yarmolinskiyam/ball_balance/solidworks/sketch_asm.SLDASM

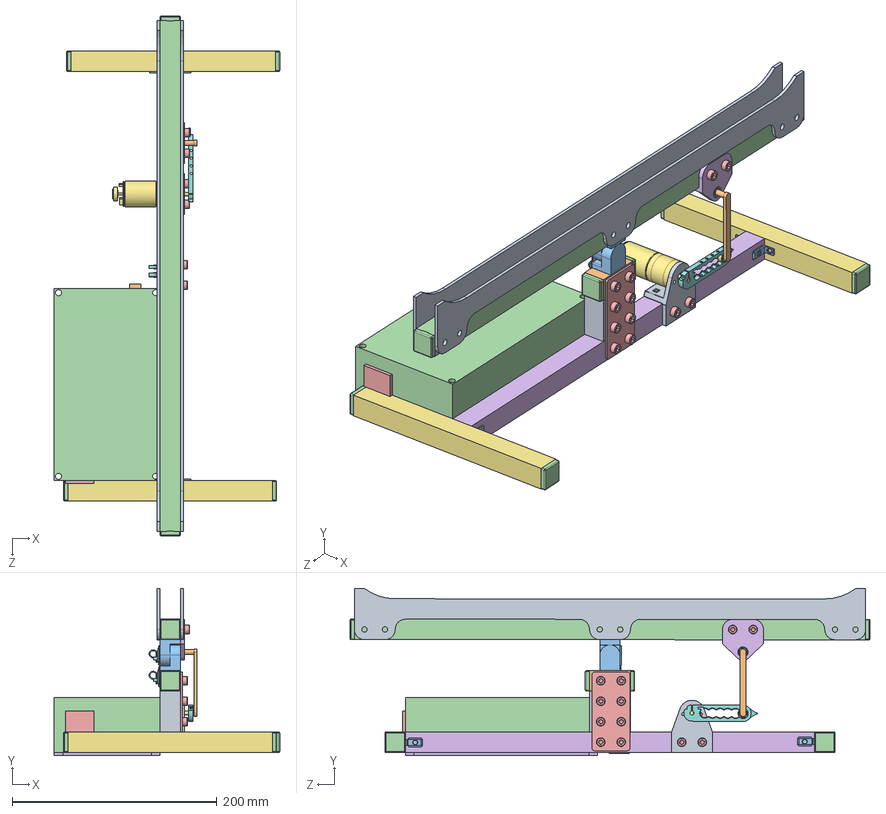
[picture p1: CAD file, 2023-07-05]
solidworks/sketch_asm.SLDASM
220.5 x 163.3 x 508.4 mm
алюм40мм^sketch_asm x 2
алюм40мм2^sketch_asm
Шарнирный соединитель 20х20, паз 6, H11^sketch_asm x 2
алюм500мм^sketch_asm
M50-Soedinitel-40kh80
arm_rocker
radial ball bearing_68_din x 2
lever
25d_motor_mount
rocker
Внутренний угловой соединитель 6-А, паз 6, H19 x 4
Заглушка торцевая 20 х 20, H17 x 8
socket head cap screw_din x 12
alum400
alum200 x 2
RS-25-5, Блок питания, 5В,5А,25Вт
Блок питания 3а 36вт 12в ip20
Simplified UNO
L298N Driver DC Motor, Stepper Motor
G1025BF, Корпус для РЭА 225х113х63мм, пластик, черный с крепежным фланцем
Разъем220сВыкл
фанераОснование
Cylindrical Brushed DC Motor
wire tie clip x 3
фанераРельс x 2
