yarmolinskiyam/ball_balance/solidworks/dxf/креплениеСонара^Сборка2_sketch_asm.DXF

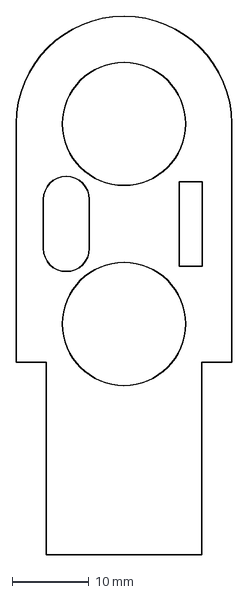
[picture p2: CAD file, 2023-07-08]
solidworks/dxf/креплениеСонара^Сборка2_sketch_asm.DXF
28.0 x 70.0 mm
