yarmolinskiyam/ball_balance/solidworks/dxf/фанераРельс_final1.DXF

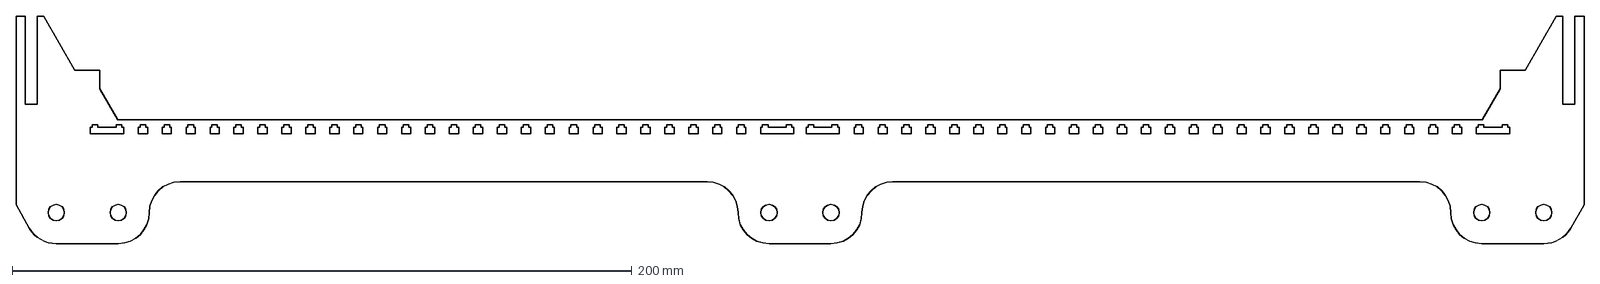
[picture p3: CAD file, 2023-07-08]
solidworks/dxf/фанераРельс_final1.DXF
506.0 x 73.3 mm
