yarmolinskiyam/ball_balance/solidworks/misc/rail_ho_g231.SLDPRT

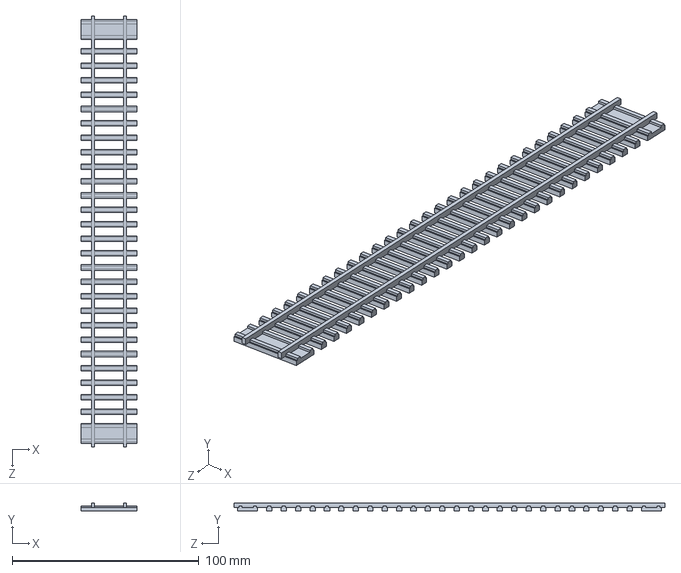
[picture p4: CAD file, 2023-07-08]
solidworks/misc/rail_ho_g231.SLDPRT
30.0 x 4.50 x 231.0 mm
