yarmolinskiyam/ball_balance/solidworks/фанераОснование.sldprt

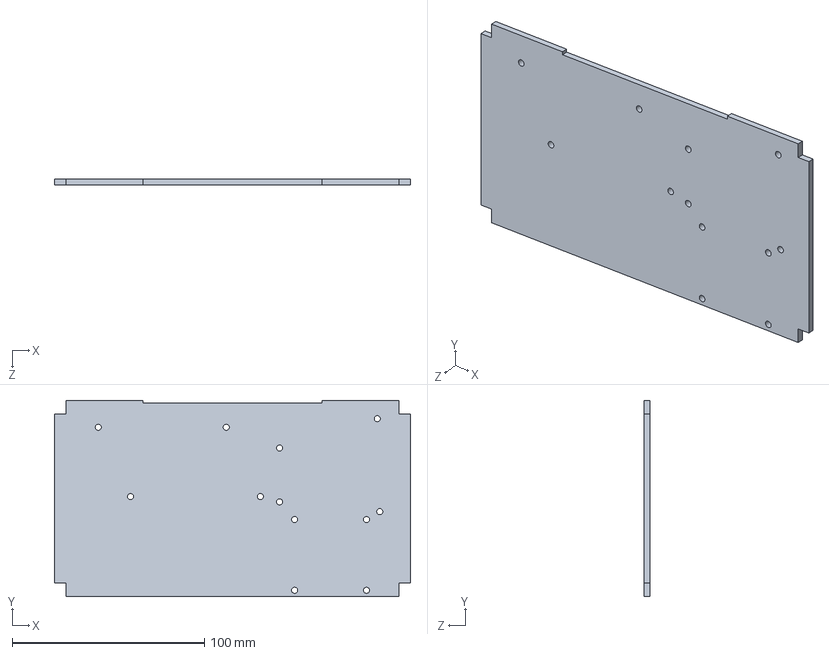
[picture p5: CAD file, 2023-07-08]
solidworks/фанераОснование.sldprt
185.0 x 102.0 x 3.00 mm
