yarmolinskiyam/ball_balance/solidworks/dxf/фанераОснование2.DXF

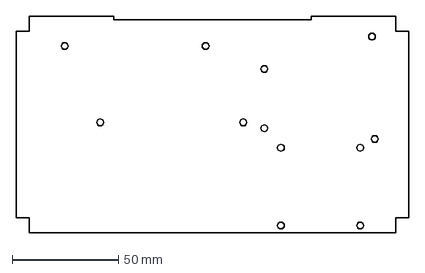
[picture p6: CAD file, 2023-07-08]
solidworks/dxf/фанераОснование2.DXF
185.0 x 102.0 mm
