yarmolinskiyam/ball_balance/solidworks/misc/G1025BF, Корпус для РЭА 225х113х63мм, пластик, черный с крепежным фланцем.SLDPRT

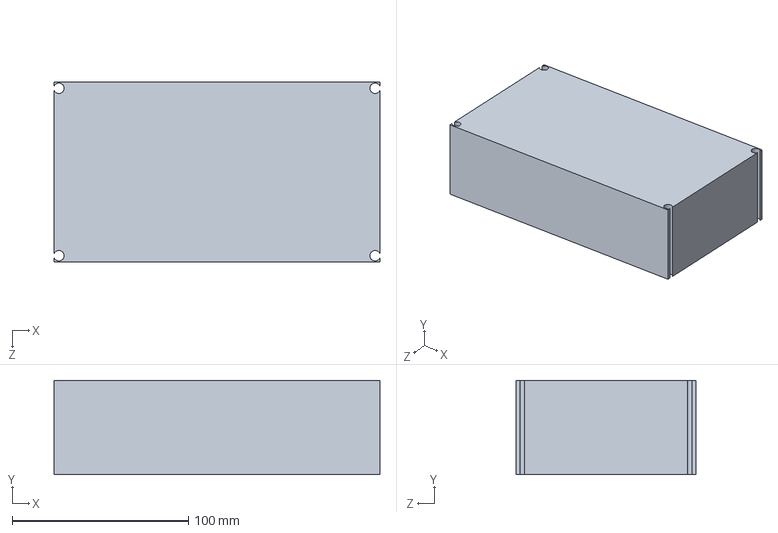
[picture p7: CAD file, 2023-07-08]
solidworks/misc/G1025BF, Корпус для РЭА 225х113х63мм, пластик, черный с крепежным фланцем.SLDPRT
185.0 x 53.5 x 102.0 mm
