yarmolinskiyam/ball_balance/solidworks/фанераРельс.SLDPRT

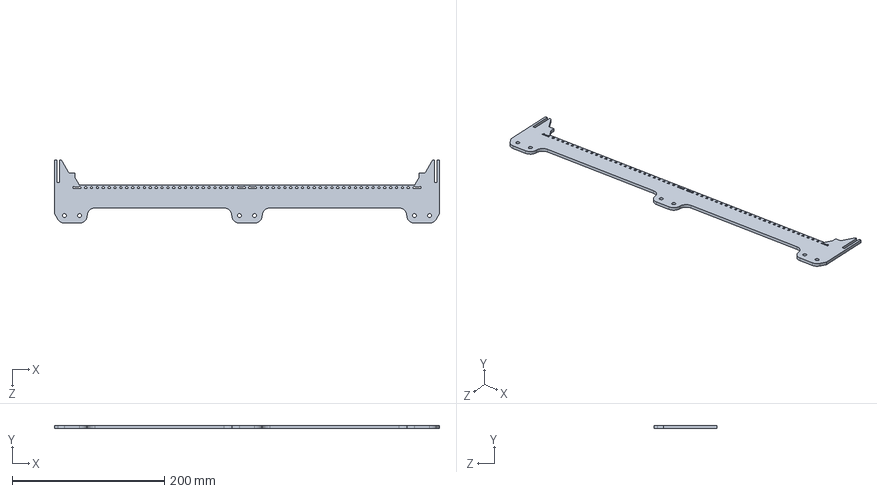
[picture p8: CAD file, 2023-07-08]
solidworks/фанераРельс.SLDPRT
506.0 x 4.00 x 83.3 mm
