yarmolinskiyam/ball_balance/solidworks/dxf/фанераРельс_final2.DXF

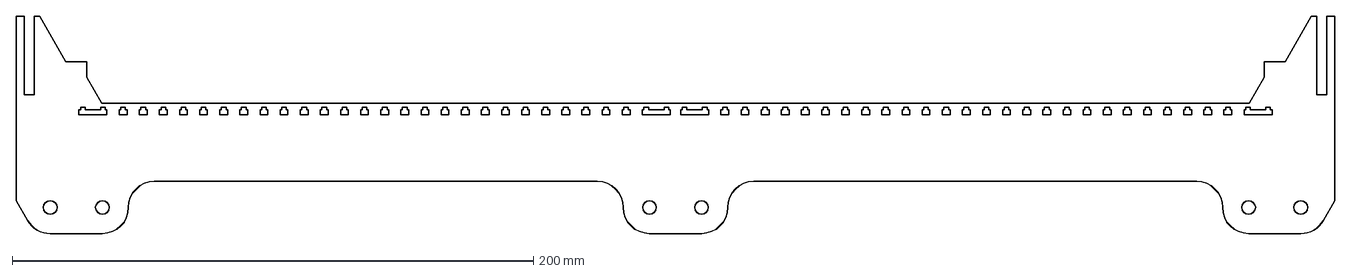
[picture p9: CAD file, 2023-07-08]
solidworks/dxf/фанераРельс_final2.DXF
506.0 x 83.3 mm
