yarmolinskiyam/ball_balance/solidworks/misc/hc-sr04.SLDPRT

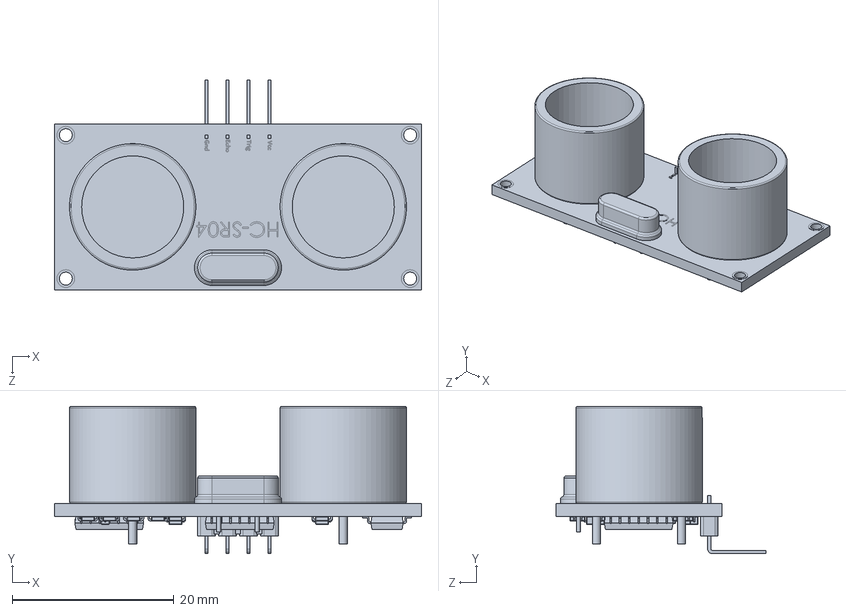
[picture p10: CAD file, 2023-07-08]
solidworks/misc/hc-sr04.SLDPRT
45.3 x 18.2 x 25.9 mm
