yarmolinskiyam/ball_balance/solidworks/креплениеМотора25d.SLDPRT

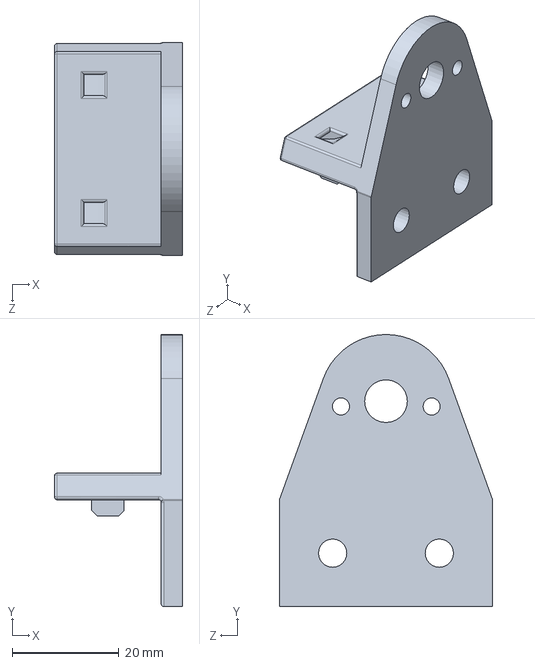
[picture p11: CAD file, 2023-07-08]
solidworks/креплениеМотора25d.SLDPRT
24.0 x 51.0 x 40.0 mm
