yarmolinskiyam/ball_balance/solidworks/dxf/фанераРельс_piko.DXF

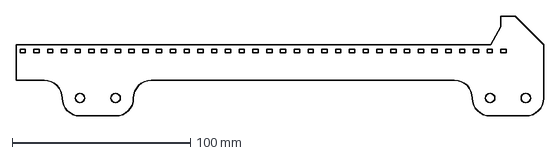
[picture p12: CAD file, 2023-07-08]
solidworks/dxf/фанераРельс_piko.DXF
295.7 x 56.0 mm
