yarmolinskiyam/ball_balance/solidworks/misc/Simplified UNO.SLDPRT

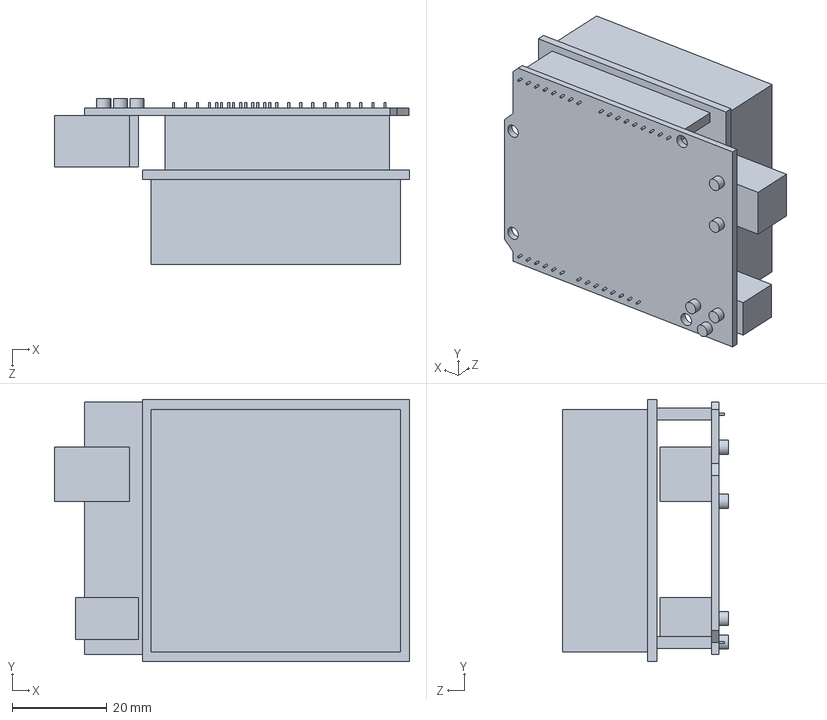
[picture p13: CAD file, 2023-07-05]
solidworks/misc/Simplified UNO.SLDPRT
75.0 x 55.5 x 35.1 mm
