yarmolinskiyam/ball_balance/solidworks/креплениеТяги.SLDPRT

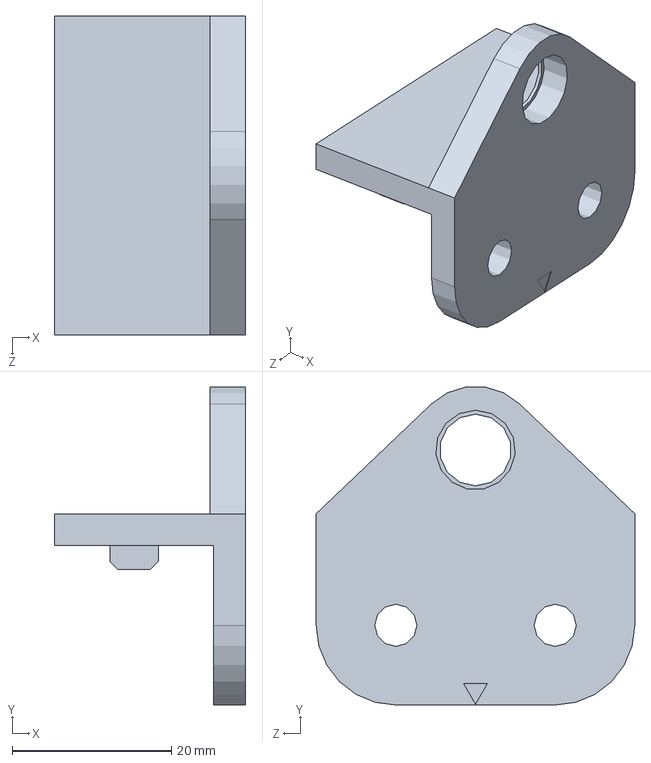
[picture p14: CAD file, 2023-07-08]
solidworks/креплениеТяги.SLDPRT
24.0 x 39.9 x 40.0 mm
