yarmolinskiyam/ball_balance/solidworks/dxf/креплениеСонара2.DXF

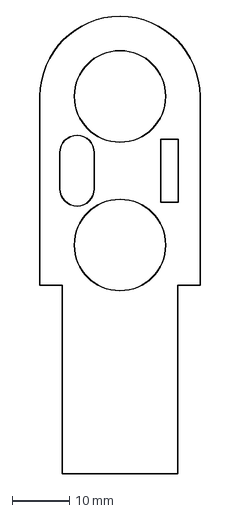
[picture p15: CAD file, 2023-07-08]
solidworks/dxf/креплениеСонара2.DXF
28.0 x 80.0 mm
