yarmolinskiyam/ball_balance/solidworks/misc/Разъем220сВыкл.SLDPRT

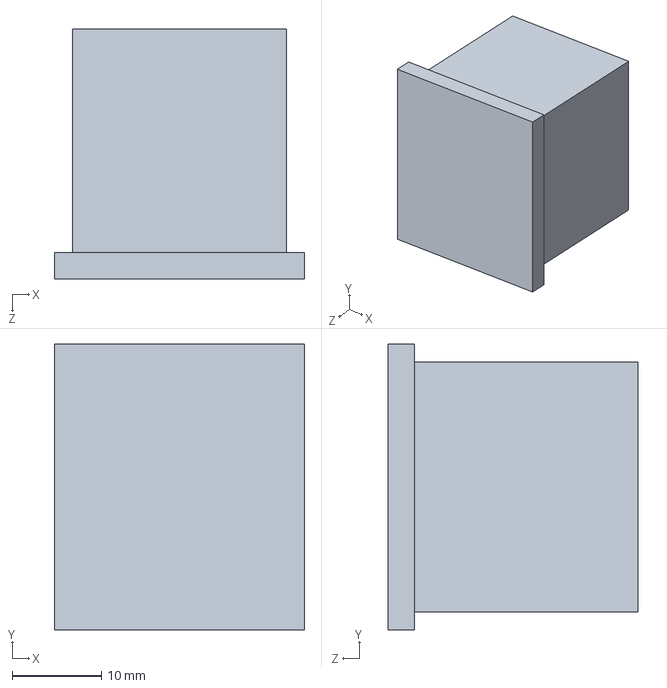
[picture p16: CAD file, 2023-07-03]
solidworks/misc/Разъем220сВыкл.SLDPRT
28.0 x 32.0 x 28.0 mm
