yarmolinskiyam/ball_balance/solidworks/dxf/фанераРельс_sonar.DXF

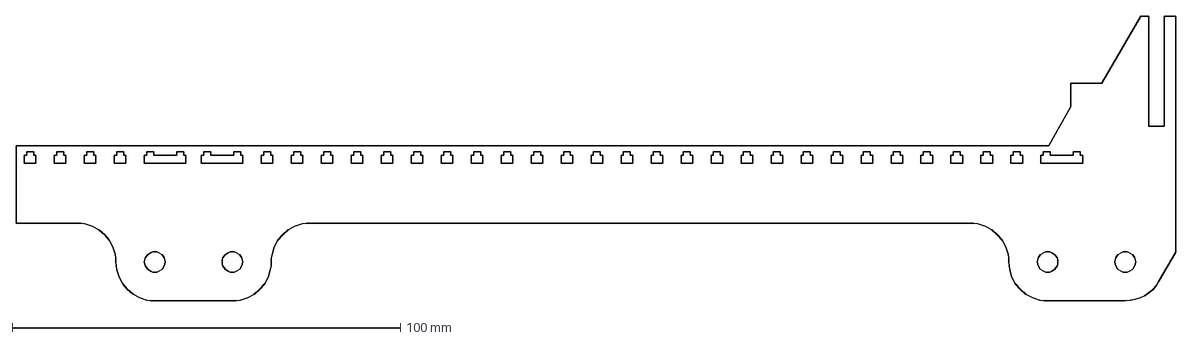
[picture p17: CAD file, 2023-07-08]
solidworks/dxf/фанераРельс_sonar.DXF
298.7 x 73.3 mm
