yarmolinskiyam/ball_balance/solidworks/lever.SLDPRT

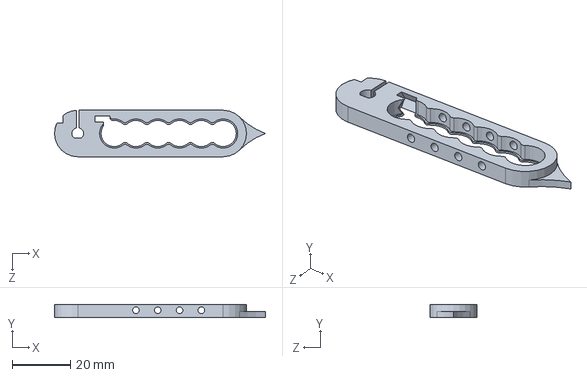
[picture p18: CAD file, 2023-07-05]
solidworks/lever.SLDPRT
72.5 x 4.50 x 16.0 mm
