yarmolinskiyam/ball_balance/solidworks/misc/Блок питания 3а 36вт 12в ip20.SLDPRT

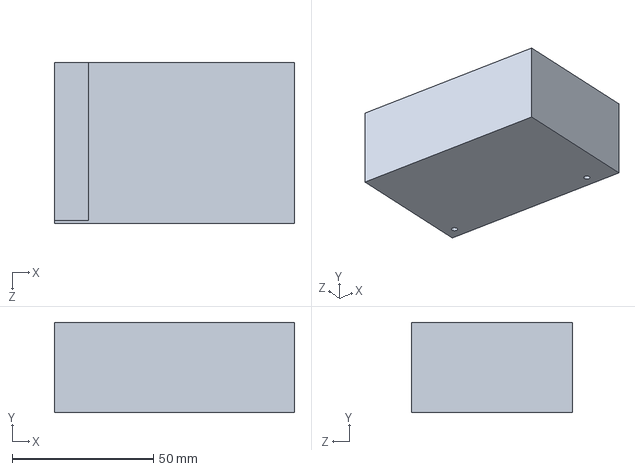
[picture p19: CAD file, 2023-07-03]
solidworks/misc/Блок питания 3а 36вт 12в ip20.SLDPRT
85.0 x 32.0 x 57.0 mm
