yarmolinskiyam/ball_balance/solidworks/dxf/фанераРельс_piko2.DXF

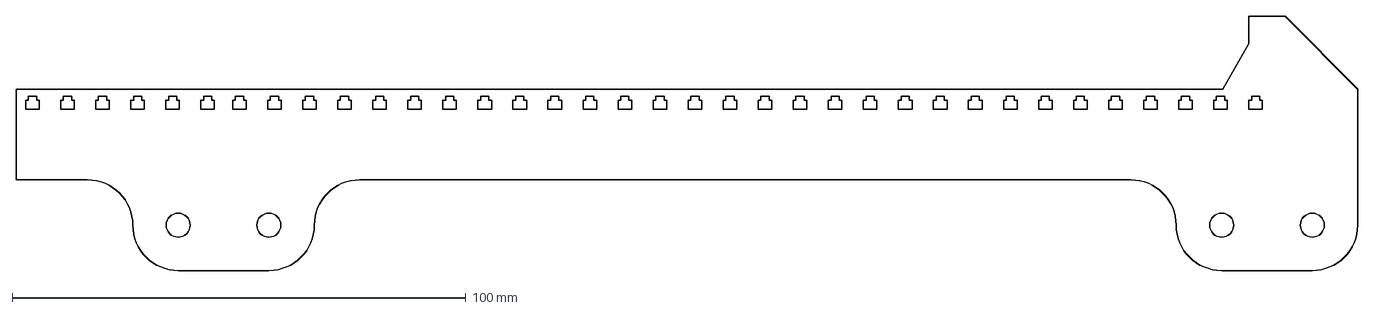
[picture p20: CAD file, 2023-07-08]
solidworks/dxf/фанераРельс_piko2.DXF
295.7 x 56.0 mm
