yarmolinskiyam/ball_balance/solidworks/misc/RS-25-5, Блок питания, 5В,5А,25Вт.SLDPRT

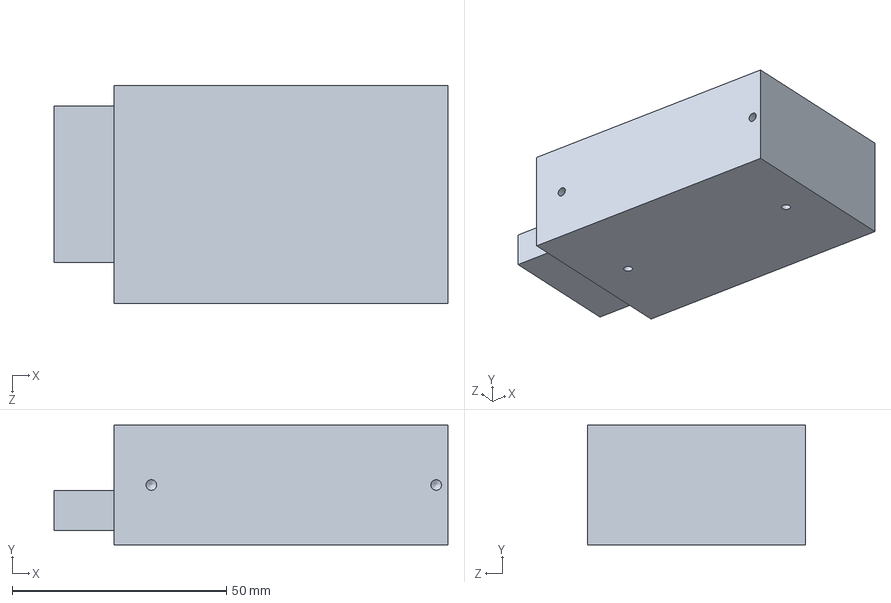
[picture p21: CAD file, 2023-06-30]
solidworks/misc/RS-25-5, Блок питания, 5В,5А,25Вт.SLDPRT
92.0 x 28.0 x 51.0 mm
