yarmolinskiyam/ball_balance/solidworks/rocker.SLDPRT

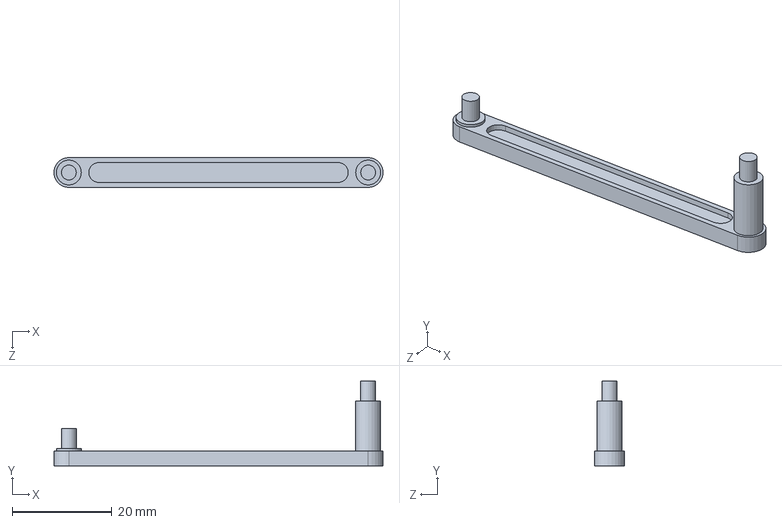
[picture p22: CAD file, 2023-06-30]
solidworks/rocker.SLDPRT
66.0 x 17.0 x 6.00 mm
