yarmolinskiyam/ball_balance/solidworks/arm_rocker_led.SLDPRT

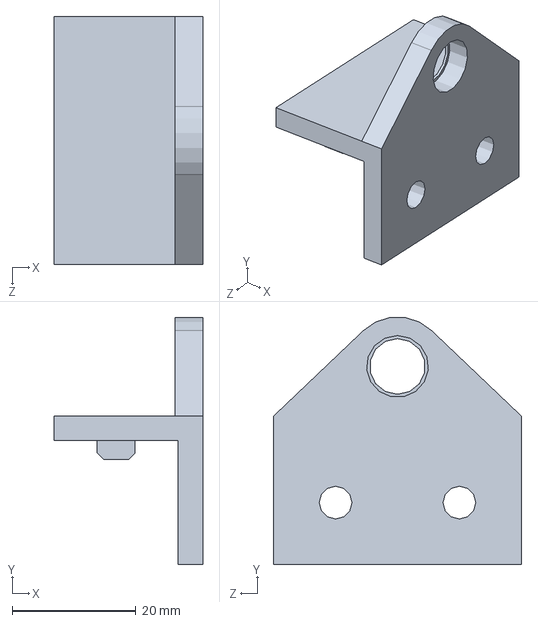
[picture p23: CAD file, 2023-06-28]
solidworks/arm_rocker_led.SLDPRT
24.0 x 39.9 x 40.0 mm
