yarmolinskiyam/ball_balance/solidworks/misc/Cylindrical Brushed DC Motor.SLDPRT

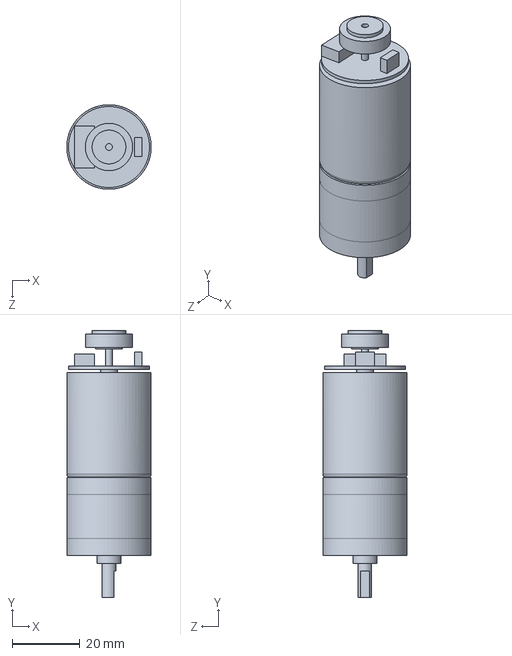
[picture p24: CAD file, 2023-06-30]
solidworks/misc/Cylindrical Brushed DC Motor.SLDPRT
25.0 x 79.0 x 25.0 mm
