yarmolinskiyam/ball_balance/solidworks/alum400.sldprt

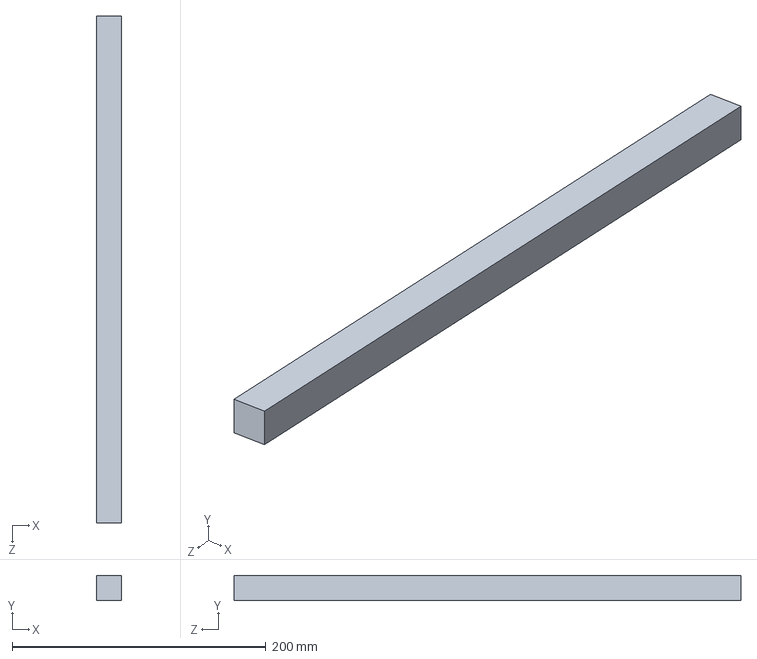
[picture p25: CAD file, 2023-06-28]
solidworks/alum400.sldprt
20.0 x 20.0 x 400.0 mm
