yarmolinskiyam/ball_balance/solidworks/misc/L298N Driver DC Motor, Stepper Motor.SLDPRT

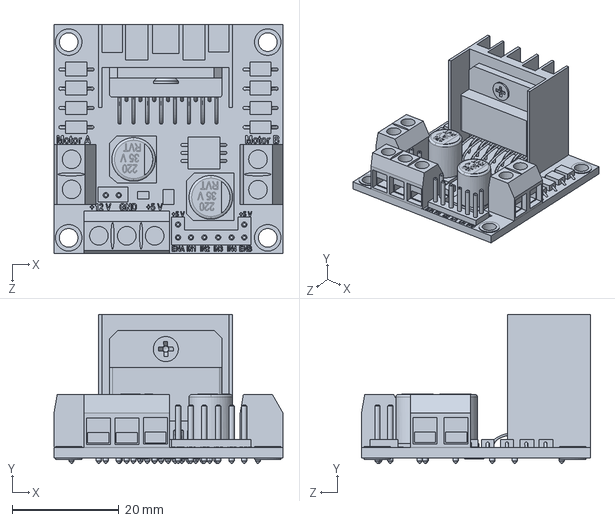
[picture p26: CAD file, 2023-06-30]
solidworks/misc/L298N Driver DC Motor, Stepper Motor.SLDPRT
43.0 x 28.0 x 43.0 mm
