yarmolinskiyam/ball_balance/solidworks/alum200.sldprt

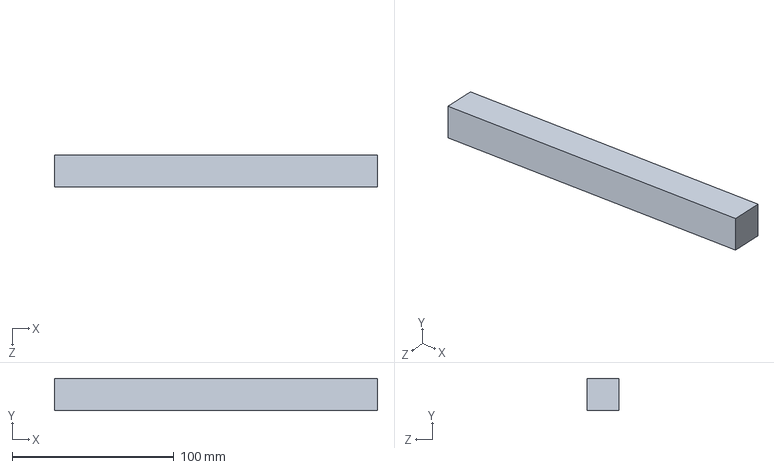
[picture p27: CAD file, 2023-06-28]
solidworks/alum200.sldprt
200.0 x 20.0 x 20.0 mm
