yarmolinskiyam/ball_balance/solidworks/misc/Внутренний угловой соединитель 6-А, паз 6, H19.SLDPRT

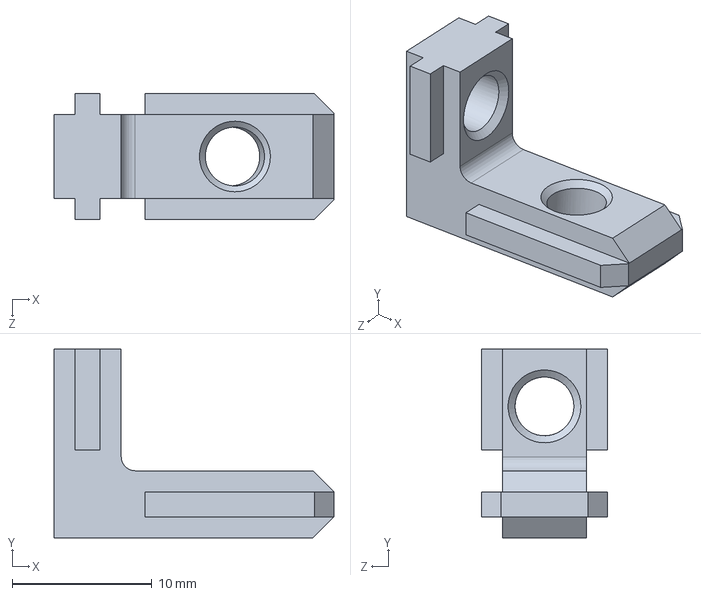
[picture p28: CAD file, 2023-06-28]
solidworks/misc/Внутренний угловой соединитель 6-А, паз 6, H19.SLDPRT
20.0 x 13.5 x 9.00 mm
