yarmolinskiyam/ball_balance/solidworks/misc/L76-T_soedinitel-80kh140.SLDPRT

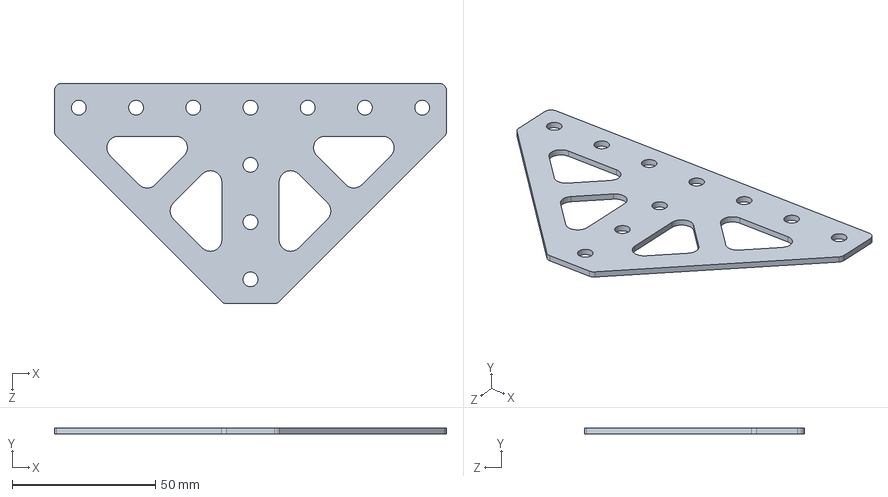
[picture p29: CAD file, 2023-06-28]
solidworks/misc/L76-T_soedinitel-80kh140.SLDPRT
137.0 x 2.00 x 77.0 mm
