yarmolinskiyam/ball_balance/solidworks/sketch.SLDPRT

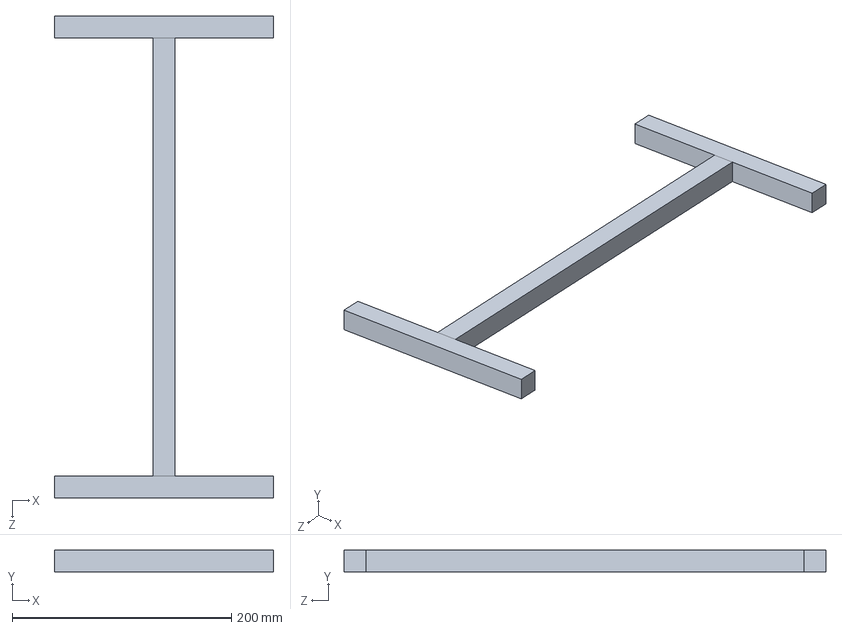
[picture p30: CAD file, 2023-06-28]
solidworks/sketch.SLDPRT
200.0 x 20.0 x 440.0 mm
