yarmolinskiyam/ball_balance/solidworks/misc/L68-T_soedinitel-40kh60.SLDPRT

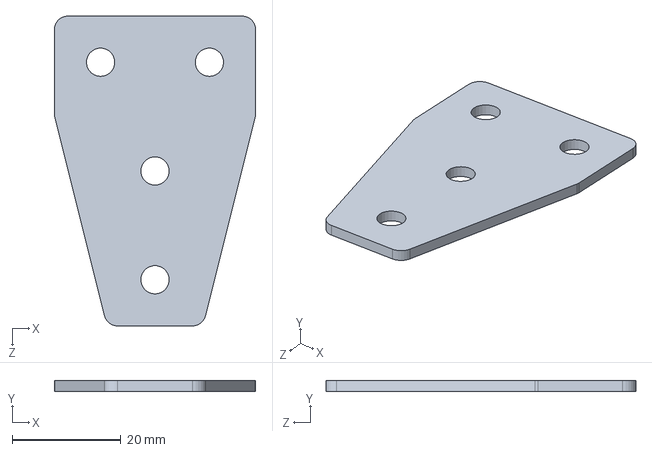
[picture p31: CAD file, 2023-06-28]
solidworks/misc/L68-T_soedinitel-40kh60.SLDPRT
37.0 x 2.00 x 57.0 mm
