yarmolinskiyam/ball_balance/solidworks/misc/Заглушка торцевая 20 х 20, H17.SLDPRT

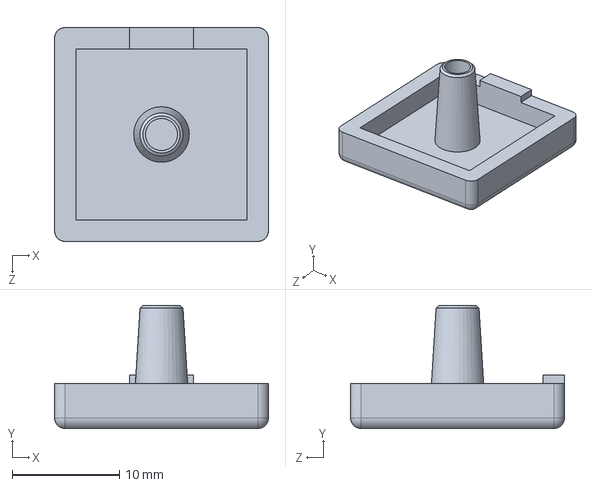
[picture p32: CAD file, 2023-06-28]
solidworks/misc/Заглушка торцевая 20 х 20, H17.SLDPRT
20.0 x 11.5 x 20.0 mm
