yarmolinskiyam/ball_balance/solidworks/misc/M50-Soedinitel-40kh80.SLDPRT

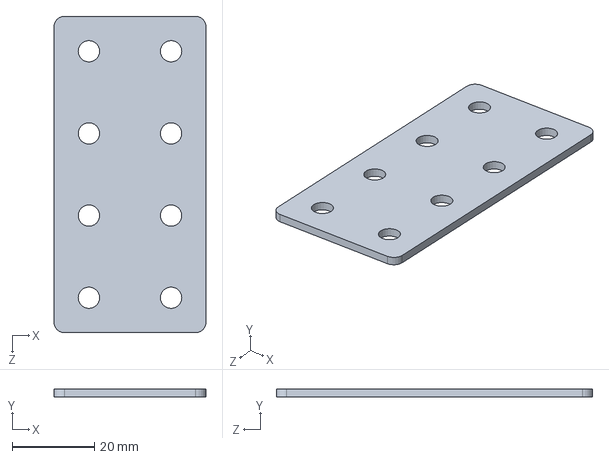
[picture p33: CAD file, 2023-06-28]
solidworks/misc/M50-Soedinitel-40kh80.SLDPRT
37.0 x 2.00 x 77.0 mm
