yarmolinskiyam/ball_balance/(list of files, cad)

Other CAD files:
solidworks/drw/sketch_asm.SLDDRW
solidworks/dxf/креплениеМотора25d.DXF
solidworks/dxf/креплениеТяги.DXF
solidworks/dxf/фанераОснование.DXF
solidworks/dxf/фанераРельс.DXF
