yarmolinskiyam/ball_balance/(list of files, drawings)

Other design files:
fritzing/schematic.fzz
