yarmolinskiyam/ball_balance/(commit log)

2023-06-25 Solid sketch
    [25d_motor_mount.SLDPRT, L68-T_soedinitel-40kh60.SLDPRT, L76-T_soedinitel-80kh140.SLDPRT, M50-Soedinitel-40kh80.SLDPRT, lever.SLDPRT, sketch.SLDPRT, sketch_asm.SLDASM]
2023-06-28 Спецификация и др
    [25d_motor_mount.SLDPRT, alum200.sldprt, alum400.sldprt, arm_rocker.SLDPRT, arm_rocker_led.SLDPRT, lever.SLDPRT, rocker.SLDPRT, sketch.SLDPRT]
2023-06-29 Причесал
    [schematic.fzz]
2023-06-29 Список компонентов
2023-06-30 Мб сонары
2023-06-30 Электронные компоненты
    [25d_motor_mount.SLDPRT, Cylindrical Brushed DC Motor.SLDPRT, G1025BF, Корпус для РЭА 225х113х63мм, пластик, черный с крепежным фланцем.SLDPRT, L298N Driver DC Motor, Stepper Motor.SLDPRT, RS-25-5, Блок питания, 5В,5А,25Вт.SLDPRT, Simplified UNO.SLDPRT, rocker.SLDPRT, sketch_asm.SLDASM]
2023-07-01 CCA провод не юзаем
2023-07-01 Суммарные количества для закупки
2023-07-01 Добавил провод для линии 5В
2023-07-01 Закупка
2023-07-02 Добавил подшипник
2023-07-03 Модель палки с автоматически настроенным регулятором
2023-07-03 Фанерка
    [arm_rocker.SLDPRT, sketch_asm.SLDASM, Блок питания 3а 36вт 12в ip20.SLDPRT, Разъем220сВыкл.SLDPRT, фанераОснование.sldprt, фанераРельс.SLDPRT]
2023-07-05 Взял моторы и сонары у ХАВ
2023-07-05 Фанера с мамой
    [G1025BF, Корпус для РЭА 225х113х63мм, пластик, черный с крепежным фланцем.SLDPRT, Simplified UNO.SLDPRT, lever.SLDPRT, sketch_asm.SLDASM, фанераОснование.DXF, фанераОснование.sldprt, фанераРельс.DXF]
2023-07-08 Посидели с мамой. Фанера и много другого
    [25d_motor_mount.SLDPRT, G1025BF, Корпус для РЭА 225х113х63мм, пластик, черный с крепежным фланцем.SLDPRT, arm_rocker.SLDPRT, hc-sr04.SLDPRT, rail_ho_g231.SLDPRT, креплениеМотора25d.DXF, креплениеМотора25d.SLDPRT, креплениеСонара2.DXF]
